adriano5458/word_clock/README.md

# word_clock

## Introduzione

Realizzare un orologio a parole (Word Clock) che mostri l'ora con delle parole scritte in una matrice di lettere trasparenti retroilluminate.  
Il progetto dovrà prevedere la realizzazione di un modello fisico di circa ```40 x 40 cm```, realizzato in maniera che, anche se prototipo, sia abbastanza curato .
