adriano5458/word_clock/diari/03_10_02_2017.md

##### WordClock SAMT 10.02.2017

# Diario

## Lavori Svolti

Dalle ore 10:05 alle 12:20:  

Alessandro ha lavorato con la parte web, per quanto riguarda
il login e il database.

Loris, ha adattato il WordClock virtuale come descritto nel Qdc.

Carlo, Massimo e Samuel hanno fatto una prova di una matrice dei led su una breadboard, per capirne il funzionamento.

Dalle ore 12:20 alle 15:00:    

Loris ha continuato il lavoro svolto in mattinata con Alessandro.

Carlo, ha continuato la documentazione che riguarda la fase di Progettazione.

Massimo e Samuel hanno continuato la realizzazione della matrice con i mosfet.

Nell'ultima ora è stato realizzato il diario, da Carlo.

## Problemi Riscontrati

Nel test della matrice abbiamo notato che quando si cerca di accendere due led in diagonale, si accende tutto il quadrato della diagonale.
Per risolvere tale problema abbiamo trovato la seguente soluzione:
In pratica, si accendono tutti i LED che si vogliono accendere sulla riga, dopo si passa alla successiva e si spengono tutti quelli accesi precedentemente. Tra le due operazioni vi è un delay di 1 'ms'.

## Punto della situazione rispetto alla pianificazione

Siamo a buon punto.

## Programma di massima per la prossima giornata di lavoro

La prossima volta realizzeremo parte del modello fisico.
