adriano5458/word_clock/diari/04_17_02_2017.md

##### WordClock SAMT 17.02.2017

# Diario

## Lavori Svolti

All'inizio della lezione abbiamo fatto una discussione tra di noi.
In seguito ci siamo incontrati con il responsabile del progetto.

Alessandro ha lavorato con la parte web, ha risolto un problema con il login e con Loris hanno finito la parte grafica del sito.

Io, Carlo e Samuel abbiamo continuato a lavorare con i mosfet, dissaldato i mosfet dal vecchio progetto, fatto lo use case, lo schema ellettrico della matrice e siamo andati avanti con la documentazione.

Nell'ultima ora è stato realizzato il diario, da Massimo.

## Problemi Riscontrati

Non sono stati ricontrati problemi.

## Punto della situazione rispetto alla pianificazione

Siamo a buon punto.

## Programma di massima per la prossima giornata di lavoro

La prossima volta realizzeremo parte del modello fisico e inieremo a scrivere il codice per le varie lingue del sito.
