adriano5458/word_clock/diari/05_24_02_2017.md

##### WordClock SAMT 24.02.2017

# Diario

## Lavori Svolti

All'inizio della lezione abbiamo incontrato il professore Barchi
per fare una ricapitolazione del materiale che abbiamo bisogno per il progetto.
Dopo aver chiarito tutte le cose da fare, ci siamo divisi i compiti.

Alla mattina Alessandro ha lavorato sul modello 3D per applicare una modifica alla simulazione del modello fisico.
Ha diminuito lo spessore poichè al posto del compensato da 4mm, usiamo il policarbonato da 3mm.
Al pomeriggio ha lavorato sulla parte web del wordclock, e ha fatto il diario.

Loris ha lavorato tutto il giorno alla parte web per risolvere altri problemi di grafica inaspettati.
Ha dunque iniziato dopo a lavorare sulla parte del menu di gestione.

Carlo e Massimo hanno realizzato tutti i pezzi in policarbonato necessari a formare la
griglia nel modello fisico.

Samuel ha fatto la documentazione ed ha lavorato sulla parte elettronica e sull'RTC con la comunicazione all'Arduino.

## Problemi Riscontrati

Non sono stati ricontrati problemi.

## Punto della situazione rispetto alla pianificazione

Siamo a buon punto.

## Programma di massima per la prossima giornata di lavoro

Tagliare i pezzi per il modello fisico e implementare la parte del sito che verrà usata per gestire il modello fisico.
