adriano5458/word_clock/diari/06_10_03_2017.md

# Word clock diario

## Lavori svolti

### Samuel

Ho fatto il disegno del circuito elettrico del word clock. Lo schema e' stato fatto in kicad.

Attualmente manca la parte di collegamento tra word-clock e arduino, perche' kicad non possiede il componente arduino, ha solamente il controllore su cui si basa `ATMEGA328P`.

### Massimo e Carlo

Massimo e Carlo hanno tagliato le varie forme del policarbonato.

### Alessandro e Loris

Alessandro e Loris hanno continuato l'orologio dinamico.
Aggiunte varie funzionalita':

1. L'orologio si puo' stoppare
2. Si possono selezionare le varie lettere da accendere o spegnere, per poi gestire il modello fisico

## Problemi riscontrati

Mentre progettavo lo schema, ho riscontrato un piccolo problema, il `CMOS4053`
possiede tre entrate con le quali si selezionano le varie uscite.
