adriano5458/word_clock/diari/10_07_04_2017.md

##### WordClock SAMT 07.04.2017

# Diario

## Lavori Svolti

Dalle ore 13:15 alle 15:45:

Alessandro si è occupato di implementare l'interfaccia di login per il modello
virtuale.

Samuel e Massimo hanno continuato le saldature iniziate la scorsa volta.

Carlo e Loris si sono occupati di iniziare ad implementare il codice di arduino.

## Problemi Riscontrati

Il software Arduino da alcuni problemi nel carimento sul dispositivo hardware, nella giornata di oggi non siamo riusciti ad ovviare il problema.

## Punto della situazione rispetto alla pianificazione

Siamo in ritardo rispetto a quanto pianificato, per la prossima settimana il codice di Arduino dovrebbe essere finito. L'implementazione delle altre lingue non è stata ancora effettuata.

## Programma di massima per la prossima giornata di lavoro

Completare il codice di arduino per la gestione dei led, implementare le altre lingue
nel sito e finire il modello fisico.
