adriano5458/word_clock/diari/14_05_05-2017.md

##### WordClock SAMT 05.05.2017

# Diario

## Lavori Svolti

**Dalle ore 08:20 alle 15:45:**

Loris ha finito la parte
del WordClock in francese sulla pagina web.

Alessandro ha ultimato il sito e ha fatto la documentazione.

Samuel e Massimo hanno lavorato per saldare i demultiplexer portarsi avanti con il modello fisico.

Carlo ha aiutato Samuel e Massimo per il modello fisico, dopodiché ha iniziato a fare
il programma del passaggio dei dati su arduino.

## Problemi Riscontrati
ci siamo accorti che i demultiplexer che abbiamo non vanno bene per quello che ci servono.

## Punto della situazione rispetto alla pianificazione

Siamo in dietro con il lavoro.

## Programma di massima per la prossima giornata di lavoro

La prossima volta si consegna.
