adriano5458/word_clock/diari/13_28_04_2017.md

##### WordClock SAMT 28.04.2017

# Diario

## Lavori Svolti

**Dalle ore 08:20 alle 12:20:**

Loris ha sistemato dei piccoli problemi grafici e poi ha iniziato la parte
del WordClock in tedesco sulla pagina web.

Alessandro si è occupato di fare lo schema in sketchup in modo da avere
un modello per ritagliare la placca nera che servirà per mostrare le lettere.

Samuel e Massimo hanno lavorato per saldare tutta la matrice di LED.

Carlo ha aiutato Samuel e Massimo per la matrice, dopodiché ha iniziato a fare
l'implementazione del programma su arduino.

**Dalle ore 13:15 alle 15:45:**

Loris si è occupato di lavorare alla versione in tedesco del WordClock
sull'interfaccia web.

Samuel e Massimo hanno finito di saldare la matrice di led ed hanno iniziato
a cercare di fare delle prove con i demultiplexer.

Carlo ha continuato a lavorare sul codice per poi fare un po' di documentazione.

## Problemi Riscontrati

Samuel e Massimo hanno riscontrato dei problemi con la matrice di LED che in
alcuni casi di test per ogni riga e colonna da qualche parte faceva un corto
e se ne accendevano su altre righe.

## Punto della situazione rispetto alla pianificazione

Siamo a buon punto.

## Programma di massima per la prossima giornata di lavoro

La prossima volta si finirà la versione francese sulla pagina web
e si lavorerà sul codice per il programma in arduino
oltre a cercare di finire la documentazione.
