adriano5458/word_clock/diari/09_31_03_2017.md

##### WordClock SAMT 10.02.2017

# Diario

## Lavori Svolti

Dalle ore 10:05 alle 12:20:  

Alessandro e Loris hanno concluso il menu a tendina contenente le varie impostazioni per il sito. 
Sono stati aggiunti dei temi(colori) predefiniti.

Carlo, Samuel e Massimo si sono occupati di preparare al meglio il modello fisico per saldarci sopra i vari ponti contenenti 
le resistenze.

Dalle ore 13:15 alle 15:45:

Alessandro e Loris, hanno implementato nell'applicativo web i colori personalizzabili, uno switch per spostarsi tra le varie lingue ed 
hanno quasi completato la funzione per gestire ogni singolo led formattato in modo da poter essere mandato all'arduino.
In aggiunta, hanno implementato delle decorazioni grafiche.

Samuel e Massimo, si sono occupati di saldare i ponti sul modello fisico.

Carlo si è occupato della documentazione ed ha scritto il diario di oggi.

## Problemi Riscontrati

Non sono stati riscontrati problemi nella giornata di oggi.

## Punto della situazione rispetto alla pianificazione

Siamo a buon punto.

## Programma di massima per la prossima giornata di lavoro

La prossima volta si inizierà l'implementazione del codice di arduino e si porterà a termine il modello virtuale.
