adriano5458/word_clock/diari/08_24_03_2017.md

# Word clock diario

## Lavori svolti

### Alessandro e Loris

All'inizio hanno implementato il menu, sull'applicativo web, utile per la personalizzazione dell'interfaccia (settaggio dei colori).

Nel pomeriggio, insieme al resto del team, hanno realizzato il supporto delle resistenze utile per il modello fisico.

### Massimo, Carlo e Samuel

Nel mattino, hanno completato le varie saldature mancanti sulla Veroboard.

Nel resto della giornata, insieme agli altri membri del gruppo, hanno iniziato a realizzare i filamenti, sul quale sono state
saldate le varie resistenze utili ai led presenti nella griglia.

## Problemi riscontrati

Non sono stati riscontrati problemi nella giornata di oggi.

## Programma di massima per la prossima giornata di lavoro
Finire i filamenti, aggiustare il supporto del modello fisico, implementare l'orologio a parole nelle altre lingue.
