adriano5458/word_clock/diari/07_17_03_2017.md

# Word clock diario

## Lavori svolti

### Samuel

Apprendimento sul funzionamento dell'RTC, ha cominciato l'implementazione del codice in Arduino per il modello fisico.

### Massimo e Carlo

Massimo e Carlo hanno finito la griglia del modello fisico, fatto i buchi per i LED e saldato i Mosfet e i Demultiplexer.

### Alessandro e Loris 

Alessandro e Loris hanno continuato l'orologio dinamico.
Aggiunte varie funzionalita':

1. Aggiunte le scritte che aiutano la comprensione del valore dei pallini dei secondi e dei minuti
2. Aggiunto il bottone per aprire il menu di personalizzazione

## Problemi riscontrati

La parete esterna del modello fisico si è staccata.

## Programma di massima per la prossima giornata di lavoro
Finire le saldature, aggiustare il supporto del modello fisico, implementare le personalizzazioni nella pagina web in italiano ed iniziare l'implementazione delle pagine web nelle altre lingue basate sul modello italiano.
