adriano5458/word_clock/diari/02_10_02_2017.md

# Lavori svolti
Alessandro e Loris hanno continuato con il prodotto virtuale. Hanno aggiunto la funzione 'responsive'. Inoltre é stata valutata la opzione di aggiungere un 'database' nel quale salvare le opzioni di default del word clock, e quelle specifiche del utente root.

Samuel, Saia e Carlo hanno creato una matrice di dimensioni ridotte, `2 [mosfet] x 2 [mosfet]`, per controllare se il funzionamento e la logica fossero corretti. Il tutto é stato fatto su una veroboard. In seguito abbiamo scritto un programma per controllarla con arduino.

# Problemi riscontrati e soluzioni

Nel test della matrice abbiamo notato che quando si cerca di accendere due led in diagonale, si accende tutto il quadrato della diagonale.
Per risolvere tale problema abbiamo trovato la seguente soluzione:
In pratica, si accendono tutti i LED che si vogliono accendere sulla riga, dopo si passa alla successiva e si spengono tutti quelli accesi precedentemente. Tra le due operazioni vi è un delay di 1 'ms'.

# Punto della situazione rispetto alla pianificazione

# Programma di massima per la prossima giornata

Finire lo schema elettrico del word clock
