adriano5458/word_clock/diari/01_01_27_2017.md

# Lavori svolti

1. Intervista con il committente
2. Analisi dei requisiti

Dall'intervista e dall'analisi siamo giunti alla conclusione che i requisiti si dividono in 3 categorie principali:
1. Ergonomia: Struttura del WordClock
2. Modello fisico: caratteristiche che il modello fisico dovrà avere
3. Modello virtuale: caratteristiche che il sito web dovrà avere

# Problemi riscontrati e soluzioni

Nessuno

# Punto della situazione rispetto alla pianificazione

Non ancora pianificata

# Programma di massima per la prossima giornata

1. Definizione dei sottorequisiti
2. Inizio fase di progettazione
