adriano5458/word_clock/diari/15_12_05_2017.md

##### WordClock SAMT 12.05.2017

# Diario

## Lavori Svolti

Loris ha scritto la documentazione del modello virtuale.

Alessandro ha migliorato il codice in javascript del sito e sistemato alcuni problemi di questo.

Samuel e Massimo hanno finito il modello fisico saldando i componenti.

Carlo alla mattina ha aiutato Samuel e Massimo con i collegamenti dai Demux ai Mosfet, mentre nel pomeriggio ha scritto la parte di documentazione riguardante le interfacce.

## Problemi Riscontrati
Il server non era pronto, quindi non abbiamo potuto caricare il sito.

## Punto della situazione rispetto alla pianificazione

Non siamo riusciti a completare la parte di collegamento fisico-virtuale.
