adriano5458/word_clock/doc/Allegati/20170317_102902.jpg

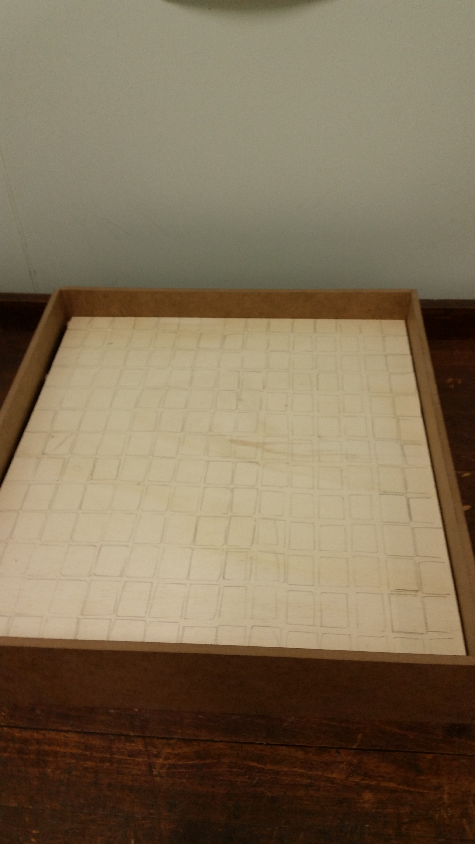
doc/Allegati/20170317_102902.jpg
