adriano5458/word_clock/doc/Allegati/20170505_132712.jpg

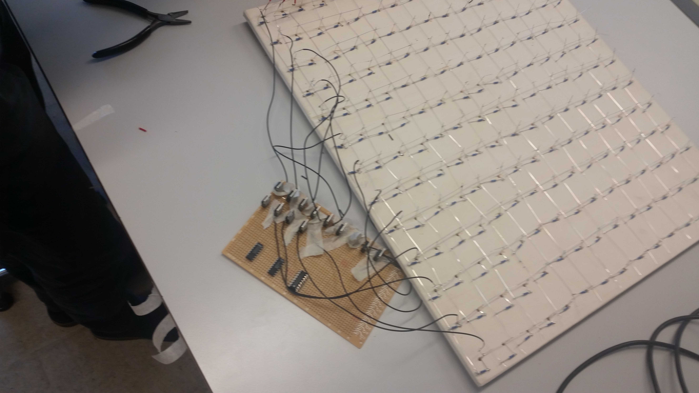
doc/Allegati/20170505_132712.jpg
