adriano5458/word_clock/doc/Allegati/20170505_132717.jpg

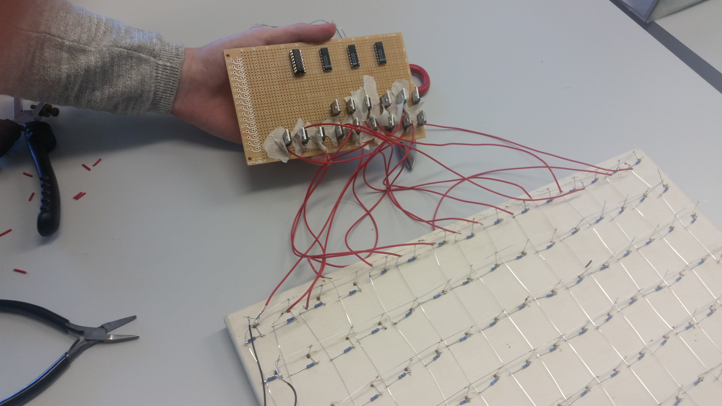
doc/Allegati/20170505_132717.jpg
