adriano5458/word_clock/doc/Allegati/De.PNG

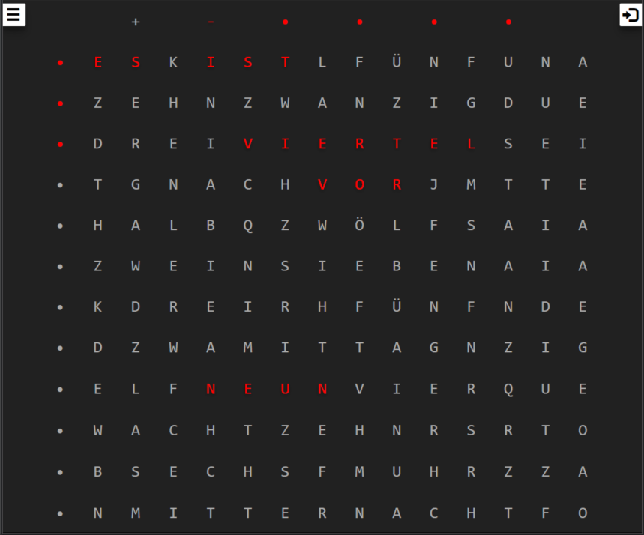
doc/Allegati/De.PNG
