adriano5458/word_clock/doc/Allegati/Fr.PNG

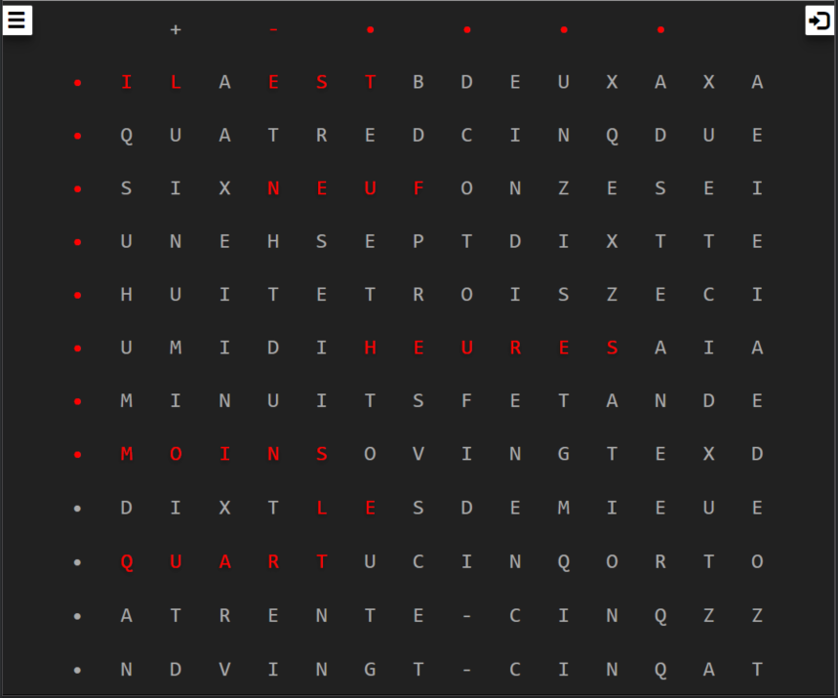
doc/Allegati/Fr.PNG
