adriano5458/word_clock/doc/Allegati/Griglia.png

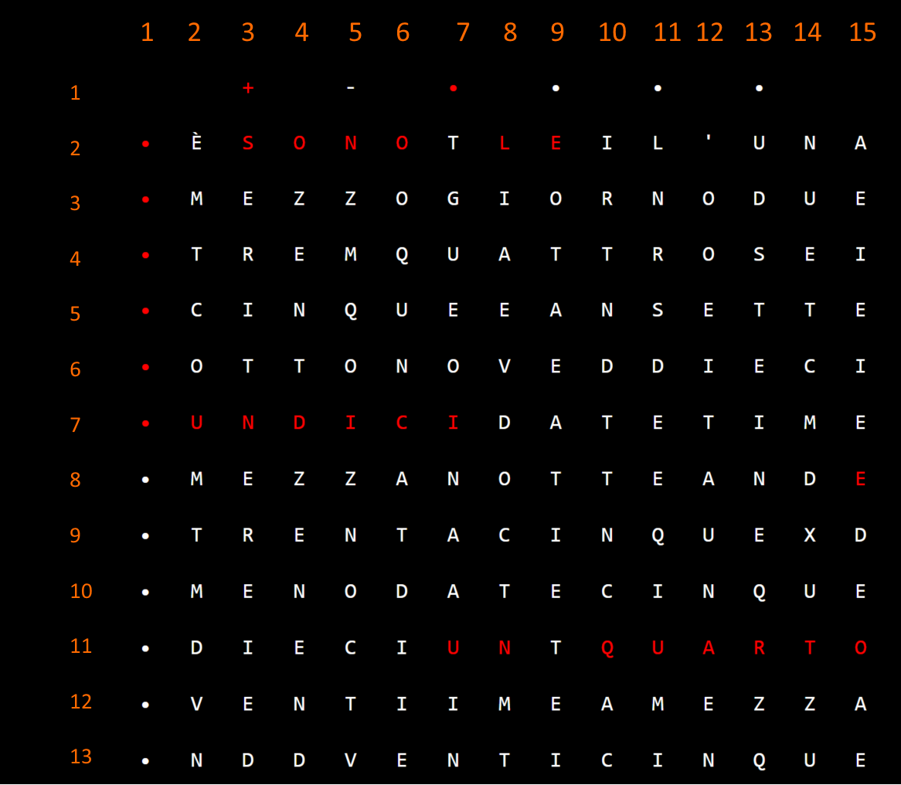
doc/Allegati/Griglia.png
