adriano5458/word_clock/doc/Allegati/veroboard.jpg

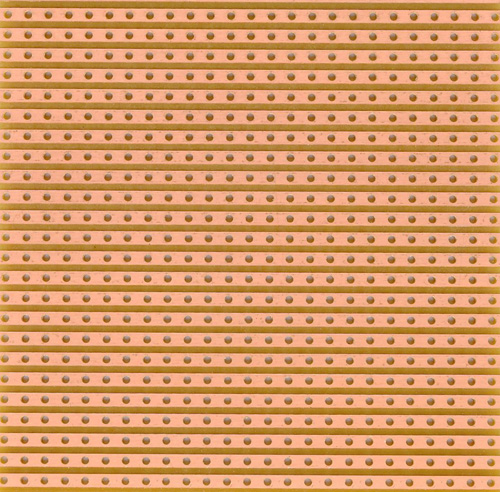
doc/Allegati/veroboard.jpg
