adriano5458/word_clock/(list of files, cad)

Other CAD files:
doc/Allegati/Modello.skp
