adriano5458/word_clock/(commit log)

2017-02-17 Use case
2017-03-10 Aggiunto schema elettrico
    [circuit.kicad_pcb, circuit.sch]
2017-05-07 Aggiornato use case
    [circuit.sch]
2017-05-10 Aggiornato svg del circuito elettrico
    [_saved_circuit.sch]
2017-05-10 Matrice doc
    [_saved_circuit.sch, circuit.sch]
2017-05-14 Aggiornata doc, test case e considerazioni personali
2017-05-14 Aggiunto file png dello schema del circuito
